oguzhancoskun/xplane-pico-switch-panel/images/render_base.png

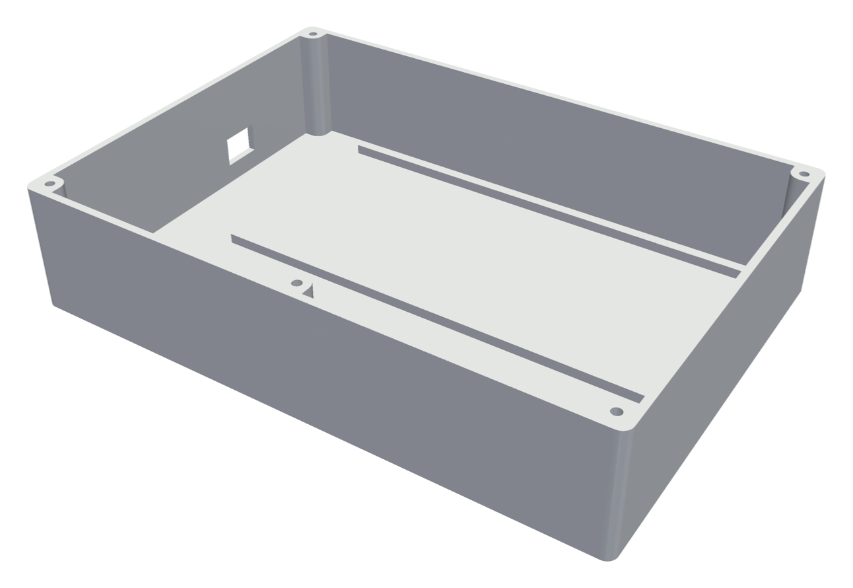
images/render_base.png
