oguzhancoskun/xplane-pico-switch-panel/images/render_lid_top.png

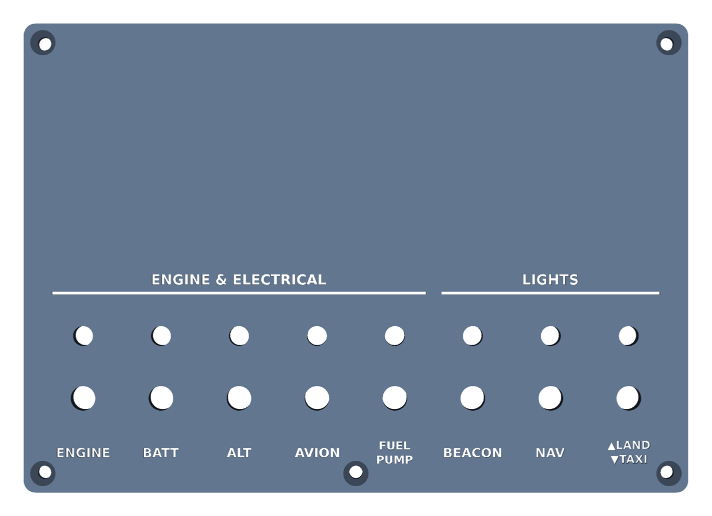
images/render_lid_top.png
