oguzhancoskun/xplane-pico-switch-panel/enclosure/lid.stl

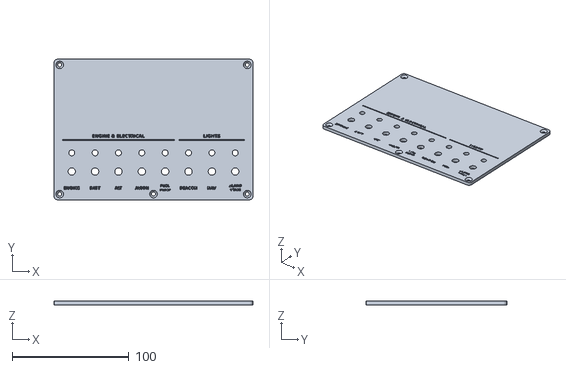
[picture p4: CAD file, 2026-10-08]
enclosure/lid.stl
170.4 x 120.4 x 3.00
