oguzhancoskun/xplane-pico-switch-panel/enclosure/base.stl

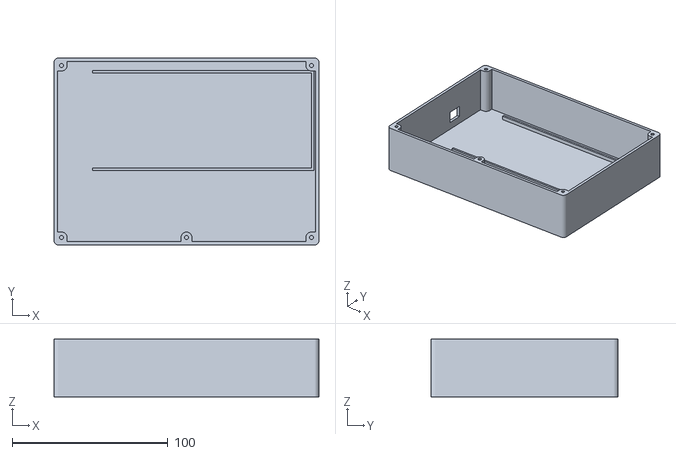
[picture p5: CAD file, 2026-10-08]
enclosure/base.stl
170.4 x 120.4 x 37.0
